buba278/p4p_gss/README.md

# p4p_gss
UOA Final Year Project - FPGA Ground Speed Sensor
