buba278/p4p_gss/(list of files, cad)

Other CAD files:
quartus/stp1.stp
