buba278/p4p_gss/(commit log)

2026-06-18 Implement base python pipeline (#2)
    * Defined estimated constants
    * Placeholder sine wave definition
    * Conversion from velocity to doppler peak freq, signal generated
    * Reverse calculation added for velocity from freq peak
    * Pipeline implementation with XCA and CFAR
    * Added first scope data, added doc strings
    * Modular pipelining implemented with CSV loading
    * Renamed output image folder and pipeline scripts folder
    * Changed output image names
    * Simplify plot pipelining and removed redundant synthetic signals
    * Add alternate noise sources and rename data files and adjust plotting for consistent axis on div by zero
    [20_05_26_00.csv, 20_05_26_01.csv]
2026-07-07 Create Quartus project, base top file, and codec init (#3)
    * Generated Quartus project qpf and qsf through wizard
    * Pin assignments defined from DE2-115 datasheet
    * Add relevant manuals
    * Generate audio_pll from Quartus IP catalogue
    * Update qsf file for added files and general quartus generate assignments
    * Update .gitignore
    * Create top level sv file with all preplanned internal module linking
    * Define clocks for Quartus timing analysis
    * Draft created for audio codec init module, config registers all defined,
    still working out I2C implementation
    * Clean formatting, terminate on NACK with flashing lights, enforce strict
    I2C standard START + STOP timings
    * Remove NACK LED, let abs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
2026-07-10 Implement I2S-rx (#11)
    * Implement i2s Rx
    * Signal tap configuration for exporting data
    * Rewrite i2s_rx for proper handling of clock domain boundaries
    * Fix definition issues against compiling, remove logging from stp1.stp
    [stp1.stp]
2026-07-15 Implement hamming window & FFT (#14)
    * Write overlap buffer write section
    * Add read side feeding into FFT
    * Latch overrun fault, make namings more intuitive, add initialistation
    logic
    * Initialise overlap buffer in top file
    * Add last forgotten commit from overlap buffer
    * Create gen_hamming_mif.py
    * Generate FFT IP
    * Move gen script and generate mif file
    * Add FFT expectation of first sample frame indicator
    * Add FFT expectation of first sample frame indicator
    * Generate rom_ip files
    * Create hamming_window.sv
    * Generate FFT IP and setup in top file
    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
    [stp1.stp]
2026-07-15 Optimise overlap buffer (#15)
    * Update overlap_buffer.sv
    * Update radar top description
    * Delete stp file as polluting commits
    * Update project files
    ---------
    [stp1.stp]
2026-08-12 Implement argmax peak tracking (#17)
    * Create power_stage.sv
    * Create argmax peak tracking and update power_stage spacing
    * Instantiate power_stage and peak_argmax
    * Create bin_to_freq.sv
    * Create placeholder freq to speed conversion
    * Adjust sv files to fix compilation errors
    * Add LCD pin configurations to qsf
    * Implement LCD display of peak freq bin
    * Implement LCD display of peak freq bin
    * Add LCD datasheet
    * Add lit review PDF for AI reference
    * Create parse_signaltap.py to convert exports to a csvplotter friendly
    format
    * Add live preview python script with supporting UART sv files
    [bin_to_freq.sv, freq_to_speed.sv, lcd_freq_display.sv, live_spectrum.py, parse_signaltap.py, peak_tracking_argmax.sv, power_stage.sv]
2026-10-11 Add XCA cross correlation peak tracker (#18)
    * Add sensor design doc to pdfs
    * Add gaussian window ROM for the XCA correlator
    * Add cross correlation peak tracker to replace argmax
    * Recalibrate mount angle to 40 degrees
    * Wire XCA peak tracker and telemetry UART into radar top
    * Add telemetry UART with raw ADC and pipeline output streaming
    * Add telemetry capture logging and analysis scripts
    * Update live spectrum viewer for tagged telemetry lines
    * Ignore data captures and local Claude settings
    * Replace single gaussian ROM with sigma 3 and 9
    * Add single width correlator core with neighbour scores
    * Rewrite peak_xca as dual width bank with interpolation
    * Extend bin_to_freq to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
